rniwase/tsuraraGB/README.md

# tsuraraGB
Nintendo Gameboy cartridge-shaped FPGA (Lattice iCE40UP5K) development board

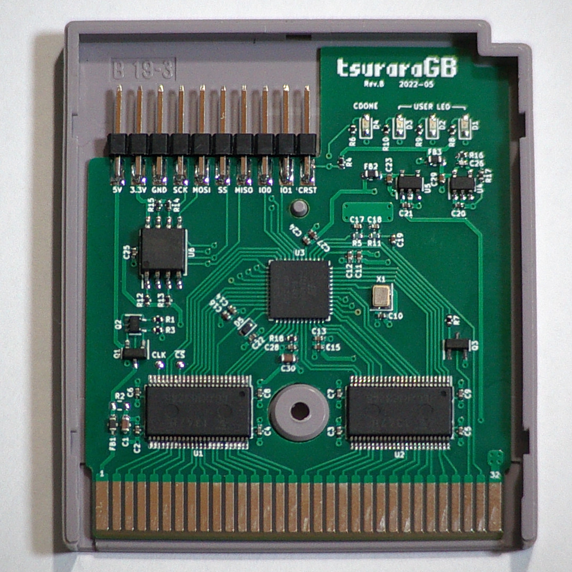
[picture p1: misc/tGB-topview.jpg]

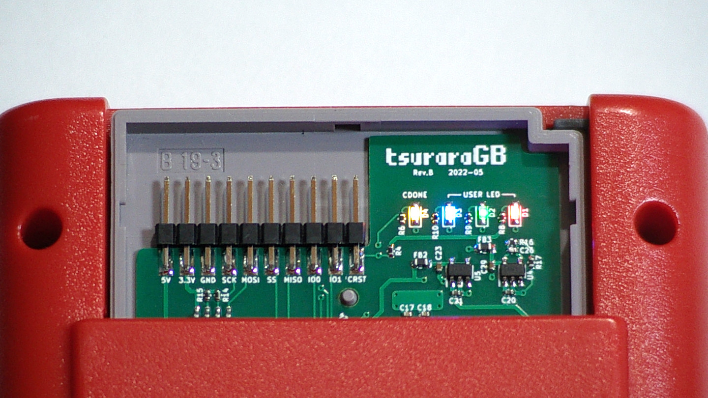
[picture p2: misc/tGB-led.jpg]
