rniwase/tsuraraGB/backpanel/tGB-Assembly.dxf

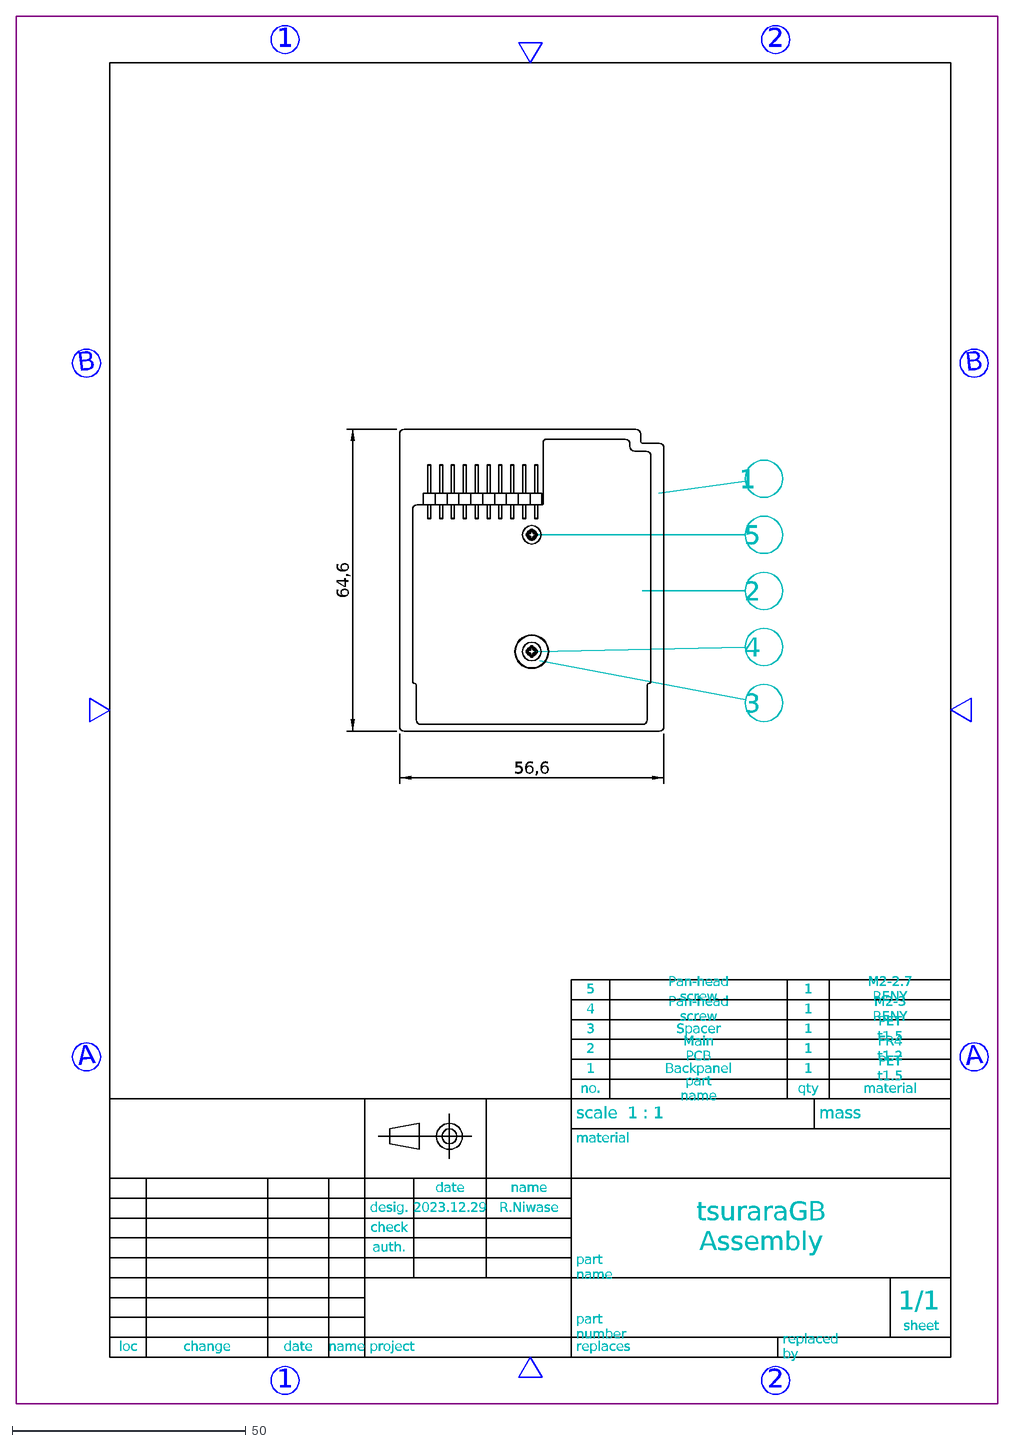
[picture p3: CAD file, 2023-12-29]
backpanel/tGB-Assembly.dxf
sheet
1/1
A
B
1
2
R.Niwase
loc
change
date
name
desig.
check
auth.
project
replaces
replaced by
part number
part name
material
mass
scale 1 : 1
no.
qty
3
4
tsuraraGB Assembly
Backpanel
Main PCB
Spacer
Pan-head screw
M2-3 RENY
5
M2-2.7 RENY
PET t1.5
FR4 t1.2
2023.12.29
56,6
64,6
