rniwase/tsuraraGB/backpanel/tGB-Backpanel.dxf

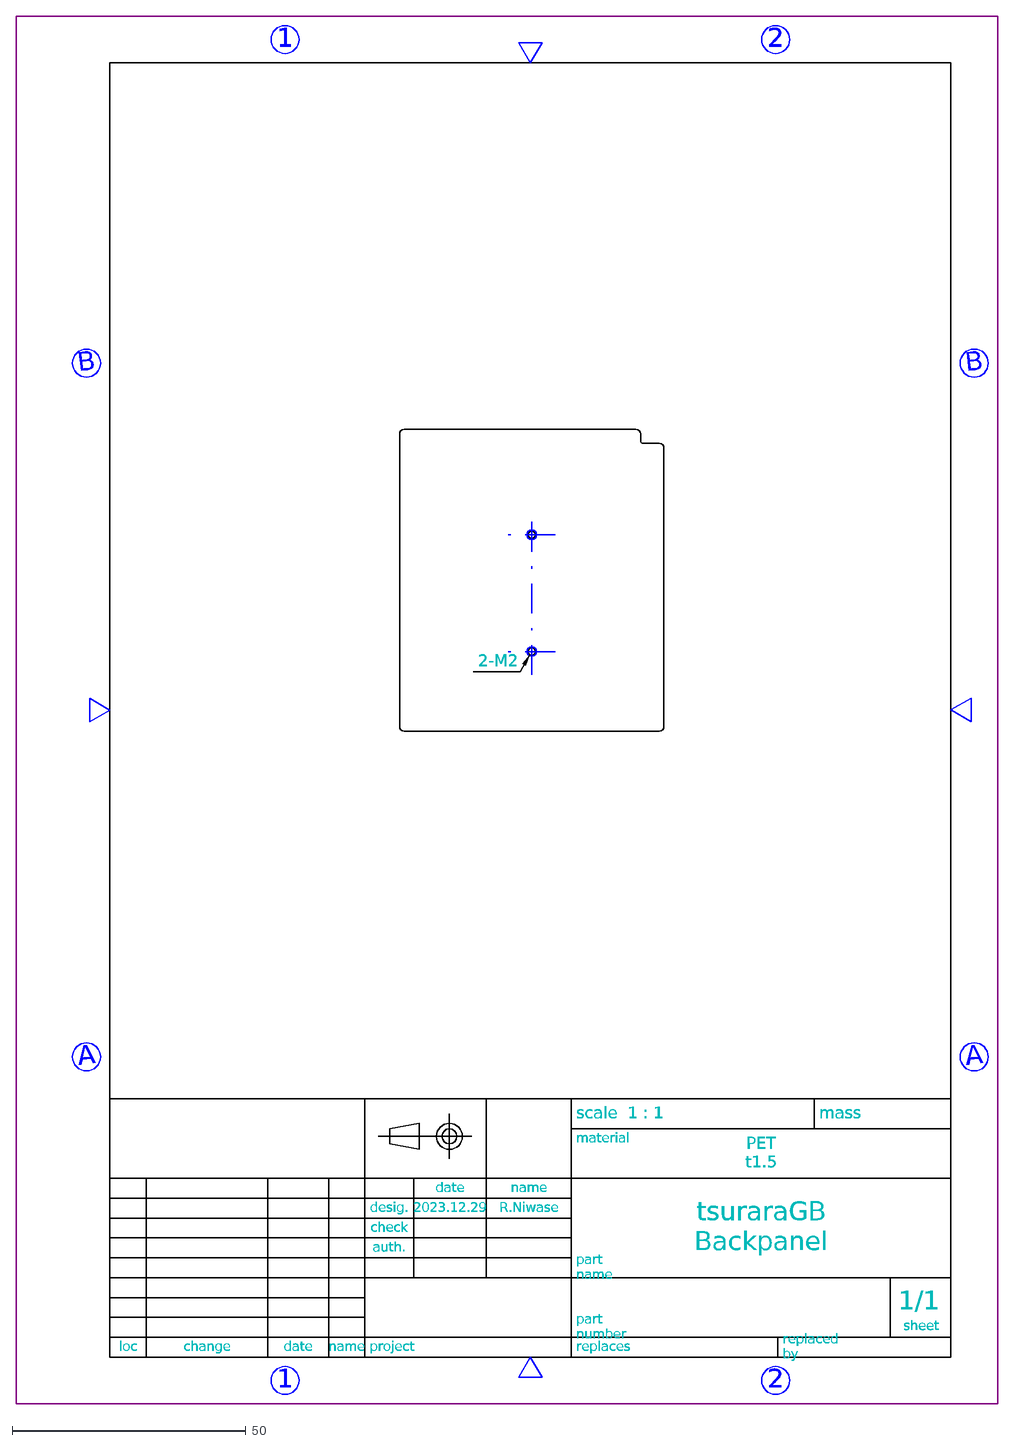
[picture p4: CAD file, 2023-12-29]
backpanel/tGB-Backpanel.dxf
sheet
1/1
A
B
1
2
tsuraraGB Backpanel
R.Niwase
loc
change
date
name
desig.
check
auth.
project
replaces
replaced by
part number
part name
material
mass
PET t1.5
scale 1 : 1
2023.12.29
2-M2
