rniwase/tsuraraGB/backpanel/tGB-Spacer.dxf

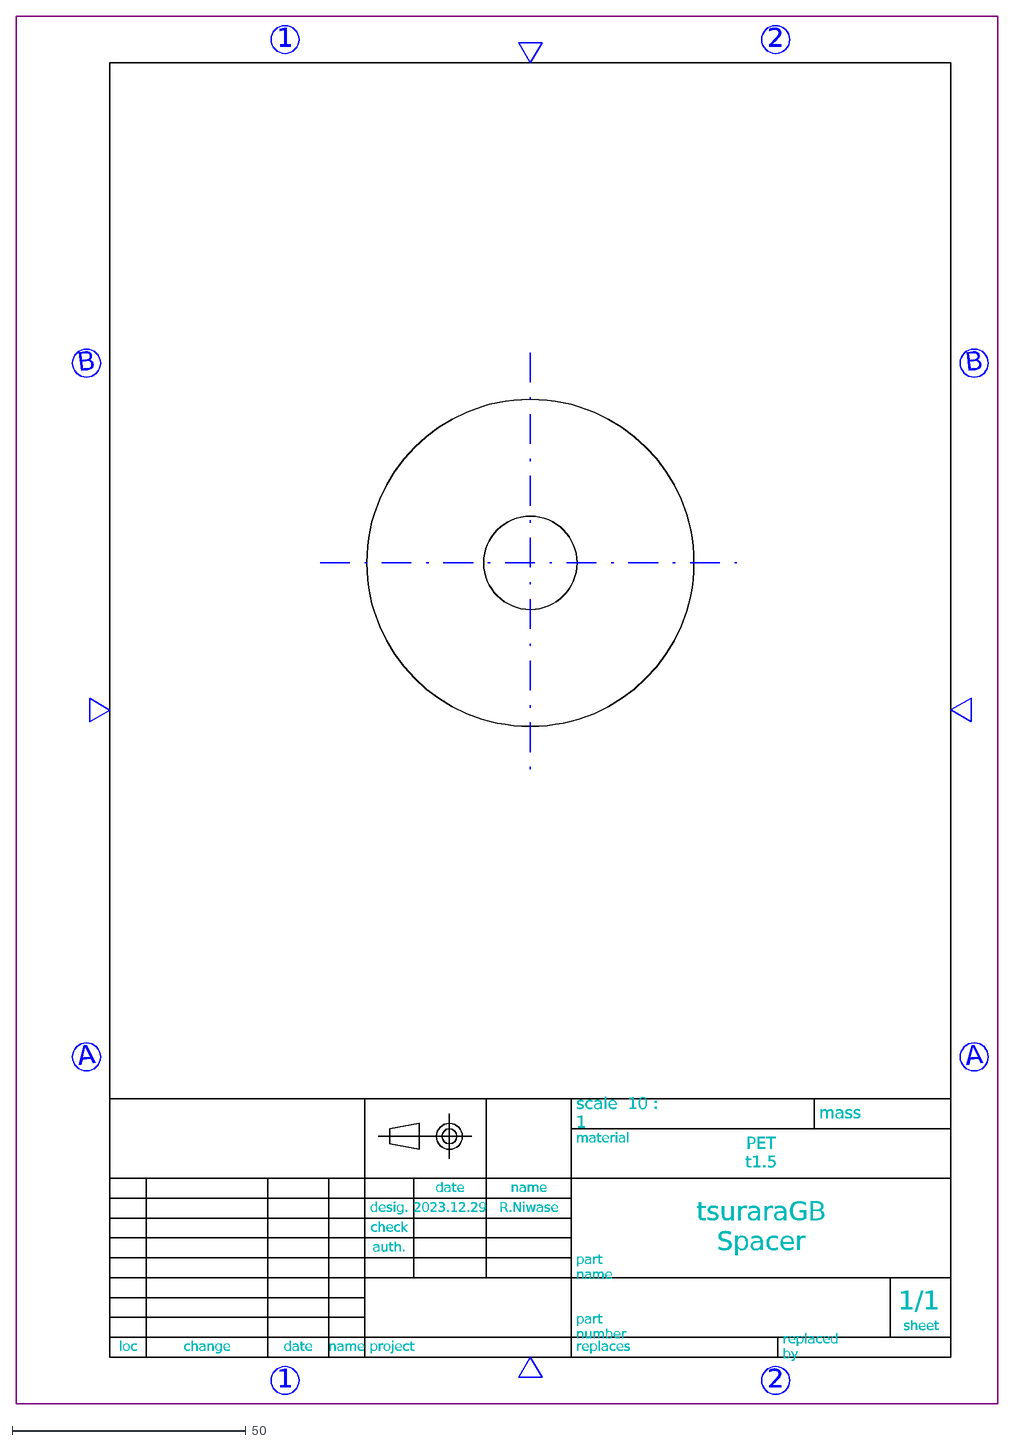
[picture p5: CAD file, 2023-12-29]
backpanel/tGB-Spacer.dxf
sheet
1/1
A
B
1
2
R.Niwase
loc
change
date
name
desig.
check
auth.
project
replaces
replaced by
part number
part name
material
mass
PET t1.5
scale 10 : 1
tsuraraGB Spacer
2023.12.29
