rniwase/tsuraraGB/pcb/programmer/tGB-prog.kicad_pcb

## KiCad design pcb/programmer/tGB-prog.kicad_pcb (2024-01-04)

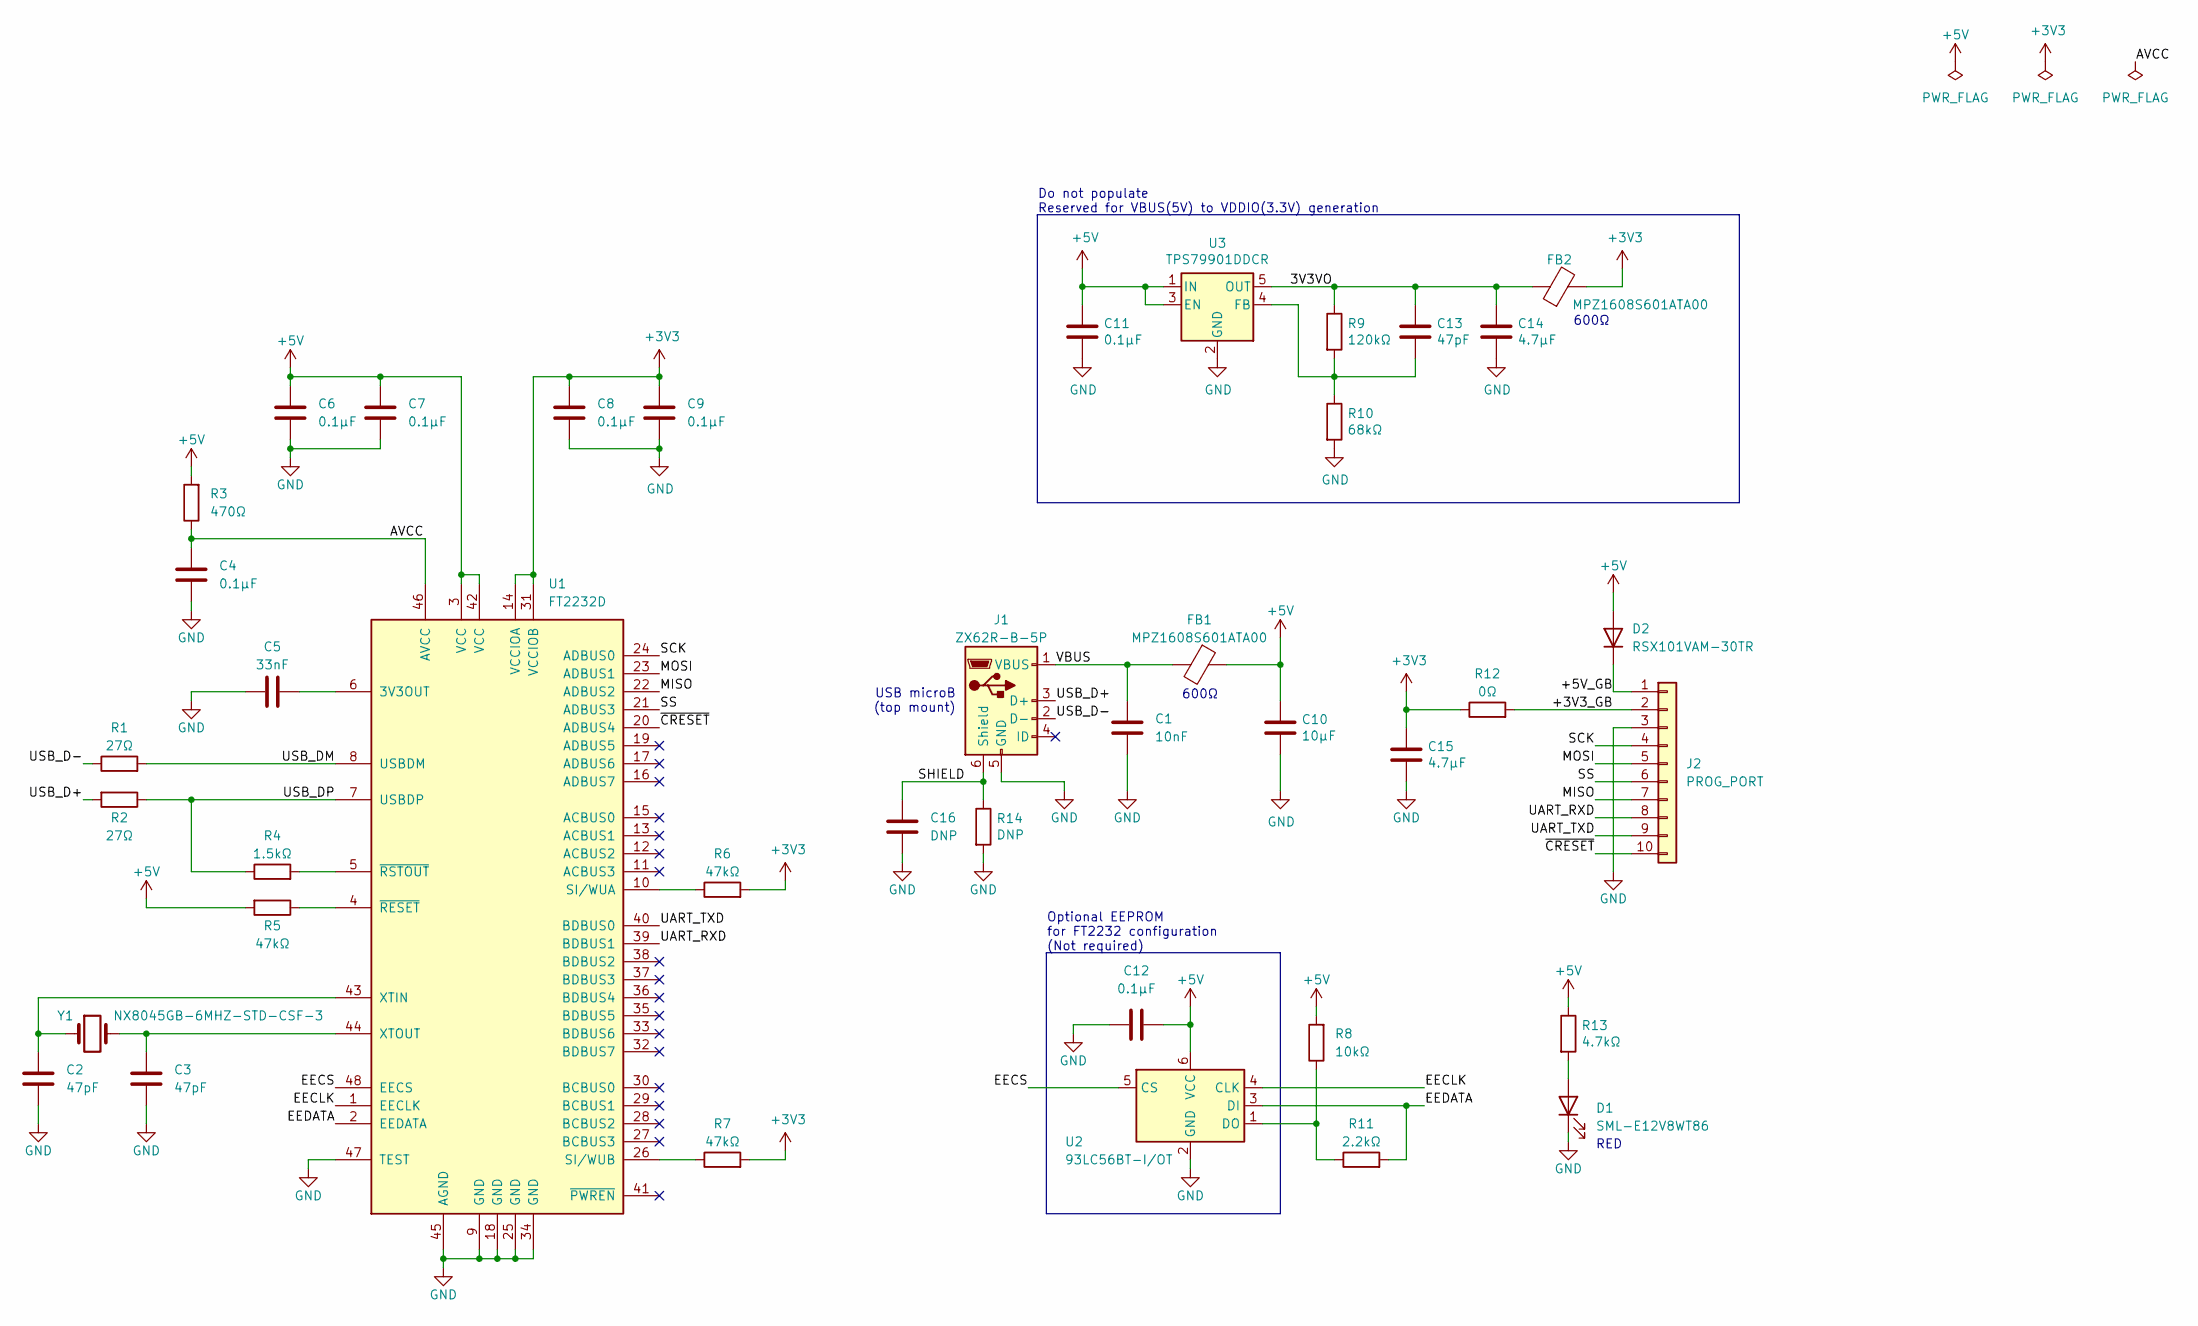
[picture p6: schematic tGB-prog.kicad_sch, tsuraraGB Programmer PCB]

Parts:
C1: 10nF; C_0402_1005Metric
C2, C3, C13: 47pF; C_0402_1005Metric
C4, C6, C7, C8, C9, C11, C12: 0.1μF; C_0402_1005Metric
C5: 33nF; C_0402_1005Metric
C10: 10μF; C_0603_1608Metric
C14: 4.7μF; C_0402_1005Metric
C15: 4.7μF; C_0603_1608Metric
C16: DNP; C_0402_1005Metric
D1: SML-E12V8WT86; LED_0603_1608Metric_Castellated
D2: RSX101VAM-30TR; D_TUMD2
FB1, FB2: MPZ1608S601ATA00; L_0603_1608Metric
J1: ZX62R-B-5P
J2: PROG_PORT; PinSocket_1x10_P2.54_Sidemount
R1, R2: 27Ω; R_0402_1005Metric
R3: 470Ω; R_0402_1005Metric
R4: 1.5kΩ; R_0402_1005Metric
R5, R6, R7: 47kΩ; R_0402_1005Metric
R8: 10kΩ; R_0402_1005Metric
R9: 120kΩ; R_0402_1005Metric
R10: 68kΩ; R_0402_1005Metric
R11: 2.2kΩ; R_0402_1005Metric
R12: 0Ω; R_0603_1608Metric
R13: 4.7kΩ; R_0402_1005Metric
R14: DNP; R_0402_1005Metric
U1: FT2232D; LQFP-48_7x7mm_P0.5mm
U2: 93LC56BT-I/OT; SOT-23-6
U3: TPS79901DDCR; SOT-23-5
Y1: NX8045GB-6MHZ-STD-CSF-3; Crystal_SMD_TXC_AX_8045-2Pin_8.0x4.5mm

Connections:
+3V3: C8.1, C9.1, C15.1, FB2.2, R6.2, R7.2, R12.1, U1.14 (VCCIOA), U1.31 (VCCIOB)
+5V: C6.1, C7.1, C10.1, C11.1, C12.2, D2.2 (A), FB1.1, R3.2, R5.2, R8.2, R13.1, U1.3 (VCC), U1.42 (VCC), U2.6 (VCC), U3.1 (IN), U3.3 (EN)
/3V3VO: C13.1, C14.1, FB2.1, R9.1, U3.5 (OUT)
/+3V3_GB: J2.2, R12.2
/+5V_GB: D2.1 (K), J2.1
/AVCC: C4.1, R3.1, U1.46 (AVCC)
/EECLK: U1.1 (EECLK), U2.4 (CLK)
/EECS: U1.48 (EECS), U2.5 (CS)
/EEDATA: R11.2, U1.2 (EEDATA), U2.3 (DI)
/MISO: J2.7, U1.22 (ADBUS2)
/MOSI: J2.5, U1.23 (ADBUS1)
/SCK: J2.4, U1.24 (ADBUS0)
/SHIELD: C16.1, J1.6 (Shield), R14.1
/SS: J2.6, U1.21 (ADBUS3)
/UART_RXD: J2.8, U1.39 (BDBUS1)
/UART_TXD: J2.9, U1.40 (BDBUS0)
/USB_D+: J1.3 (D+), R2.2
/USB_D-: J1.2 (D-), R1.1
/USB_DM: R1.2, U1.8 (USBDM)
/USB_DP: R2.1, R4.1, U1.7 (USBDP)
/VBUS: C1.1, FB1.2, J1.1 (VBUS)
/~CRESET: J2.10, U1.20 (ADBUS4)
GND: C1.2, C2.2, C3.2, C4.2, C5.1, C6.2, C7.2, C8.2, C9.2, C10.2, C11.2, C12.1, C14.2, C15.2, C16.2, D1.1 (K), J1.5 (GND), J2.3, R10.2, R14.2, U1.9 (GND), U1.18 (GND), U1.25 (GND), U1.34 (GND), U1.45 (AGND), U1.47 (TEST), U2.2 (GND), U3.2 (GND)
unnamed: D1.2 (A), R13.2
unnamed: C5.2, U1.6 (3V3OUT)
unnamed: R6.1, U1.10 (SI/WUA)
unnamed: R7.1, U1.26 (SI/WUB)
unnamed: C2.1, U1.43 (XTIN), Y1.1
unnamed: C3.1, U1.44 (XTOUT), Y1.2
unnamed: R5.1, U1.4 (~RESET)
unnamed: R4.2, U1.5 (~RSTOUT)
unnamed: R8.1, R11.1, U2.1 (DO)
unnamed: C13.2, R9.2, R10.1, U3.4 (FB)

Notes on the sheet:
600Ω
USB microB (top mount)
RED
Do not populate Reserved for VBUS(5V) to VDDIO(3.3V) generation
Optional EEPROM for FT2232 configuration (Not required)

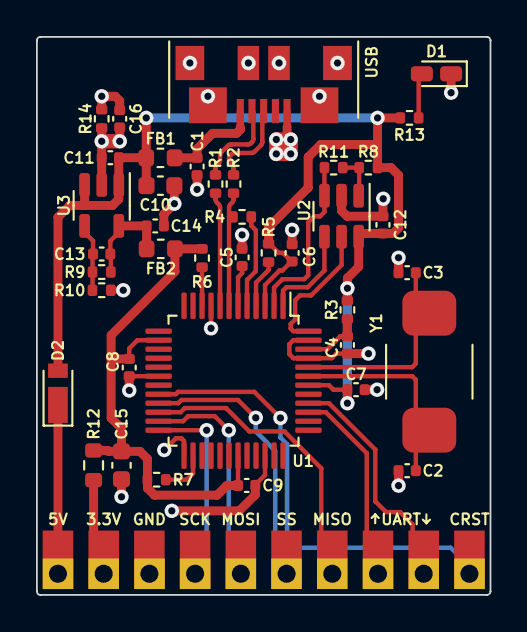
[picture p7: board tGB-prog.kicad_pcb from above]

Board: 2 copper layers, 25.2 x 31.0 mm, 40 parts (0 on the bottom side), 33 nets.
