rniwase/tsuraraGB/pcb/midi/tGB-midi.kicad_pcb

## KiCad design pcb/midi/tGB-midi.kicad_pcb (2024-01-04)

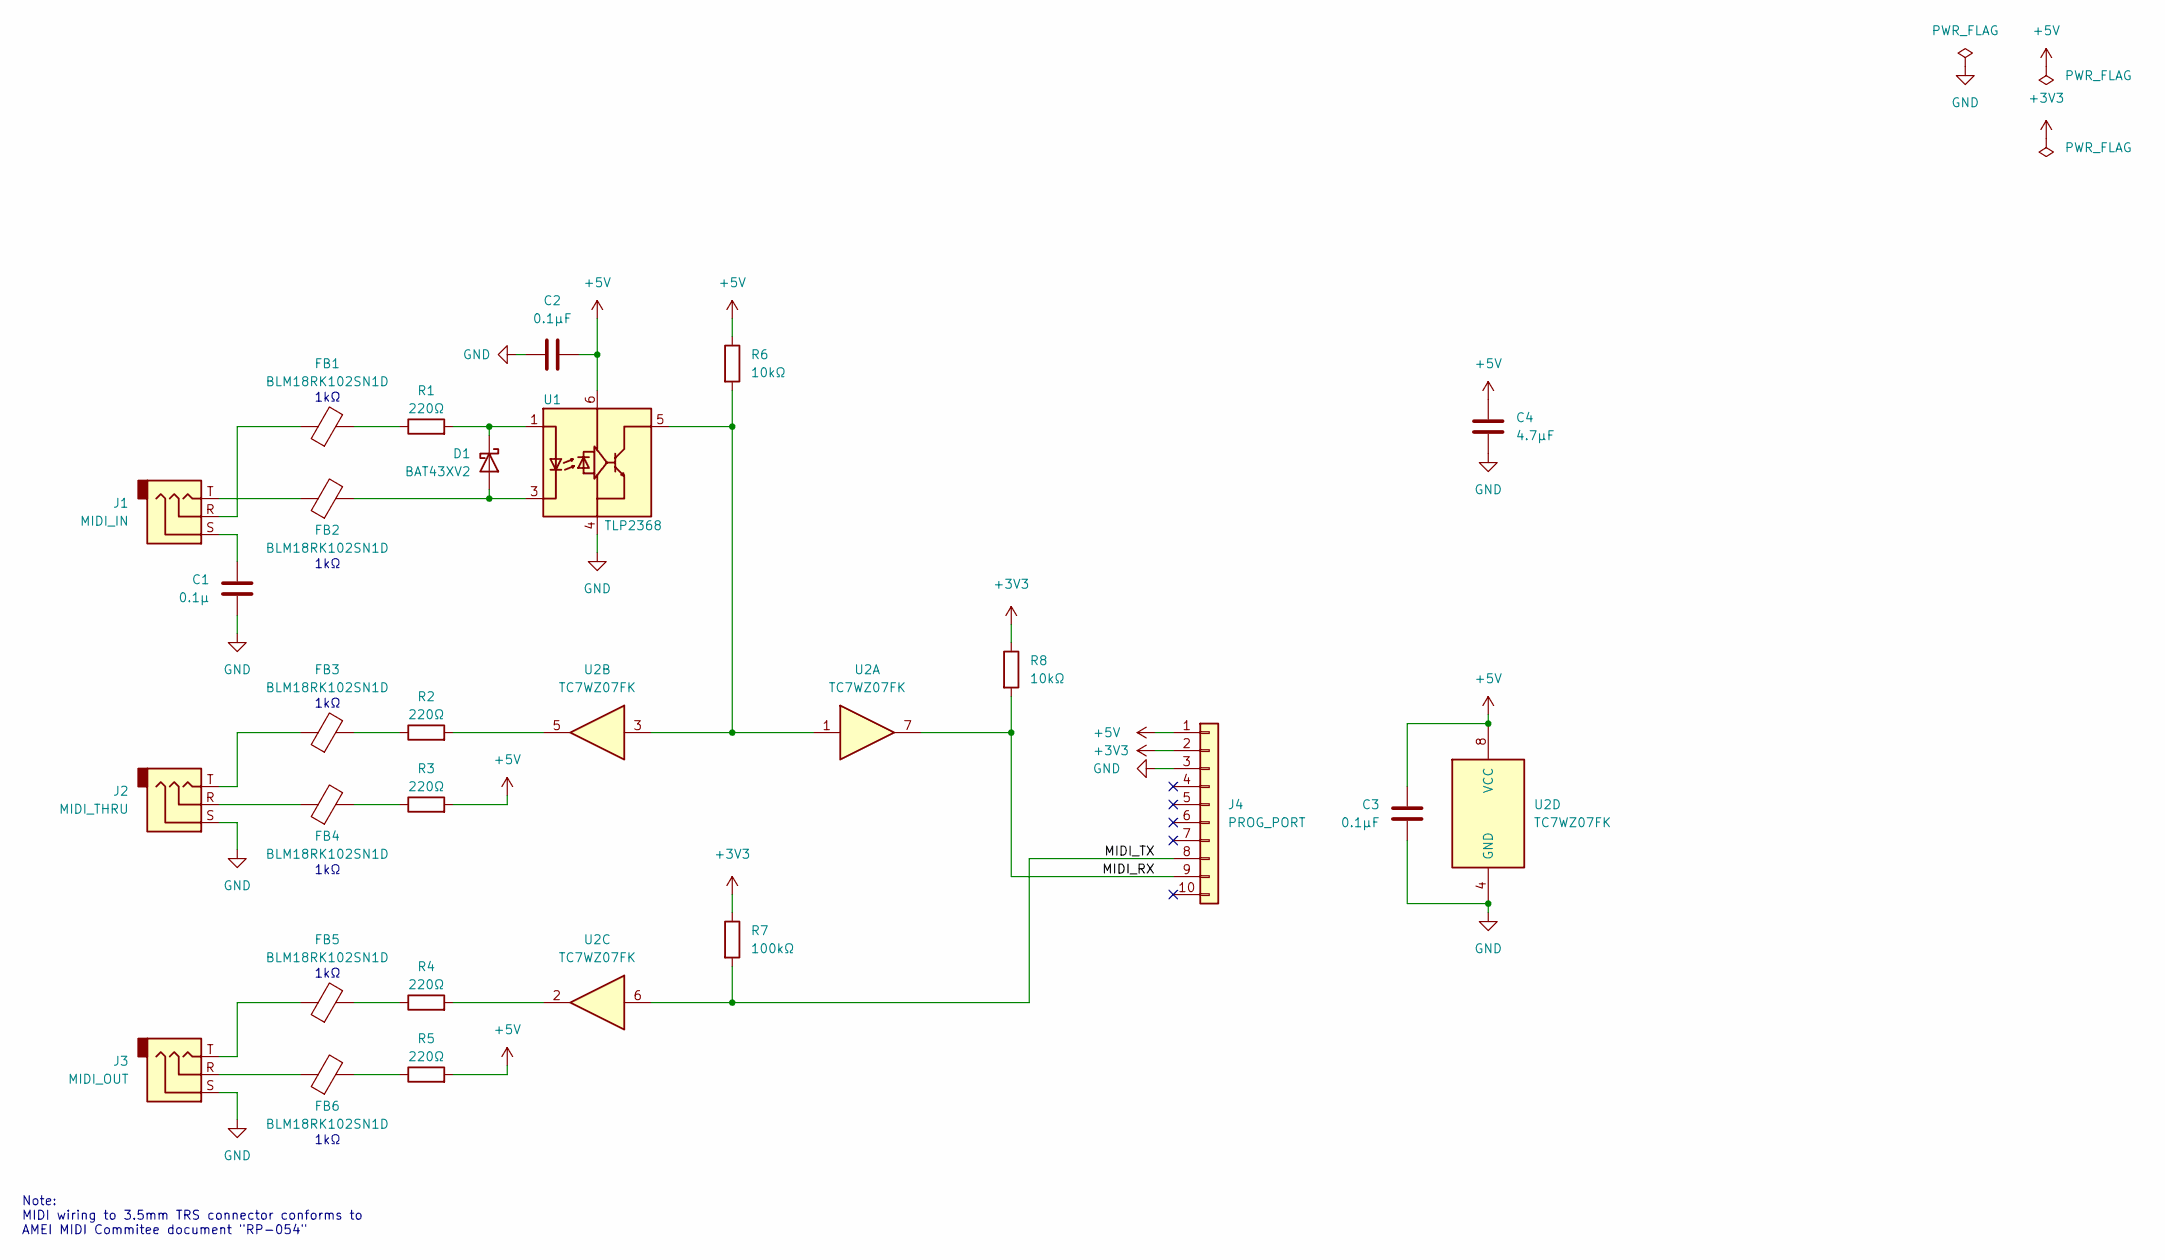
[picture p8: schematic tGB-midi.kicad_sch, tsuraraGB MIDI Adapter PCB]

Parts:
C1: 0.1μ; C_0402_1005Metric
C2, C3: 0.1μF; C_0402_1005Metric
C4: 4.7μF; C_0402_1005Metric
D1: BAT43XV2; D_SOD-523
FB1, FB2, FB3, FB4, FB5, FB6: BLM18RK102SN1D; L_0603_1608Metric
J1: MIDI_IN; MJ-8435
J2: MIDI_THRU; MJ-8435
J3: MIDI_OUT; MJ-8435
J4: PROG_PORT; PinSocket_1x10_P2.54_Sidemount
R1, R2, R3, R4, R5: 220Ω; R_0402_1005Metric
R6, R8: 10kΩ; R_0402_1005Metric
R7: 100kΩ; R_0402_1005Metric
U1: TLP2368; SO-5_4.4x3.6mm_P1.27mm
U2: TC7WZ07FK; VSSOP-8_2.3x2mm_P0.5mm

Connections:
+3V3: J4.2, R7.1, R8.1
+5V: C2.2, C3.2, C4.1, J4.1, R3.2, R5.2, R6.1, U1.6 (VDD), U2.8 (VCC)
/MIDI_RX: J4.9, R8.2, U2.7
/MIDI_TX: J4.8, R7.2, U2.6
GND: C1.1, C2.1, C3.1, C4.2, J2.S, J3.S, J4.3, U1.4 (GND), U2.4 (GND)
unnamed: C1.2, J1.S
unnamed: D1.2 (A), FB2.2, U1.3 (K)
unnamed: D1.1 (K), R1.2, U1.1 (A)
unnamed: FB1.1, J1.R
unnamed: FB1.2, R1.1
unnamed: FB2.1, J1.T
unnamed: FB3.1, J2.T
unnamed: FB3.2, R2.1
unnamed: FB4.1, J2.R
unnamed: FB4.2, R3.1
unnamed: FB5.1, J3.T
unnamed: FB5.2, R4.1
unnamed: FB6.1, J3.R
unnamed: FB6.2, R5.1
unnamed: R2.2, U2.5
unnamed: R4.2, U2.2
unnamed: R6.2, U1.5 (VO), U2.1, U2.3

Notes on the sheet:
1kΩ
Note: MIDI wiring to 3.5mm TRS connector conforms to AMEI MIDI Commitee document "RP-054"

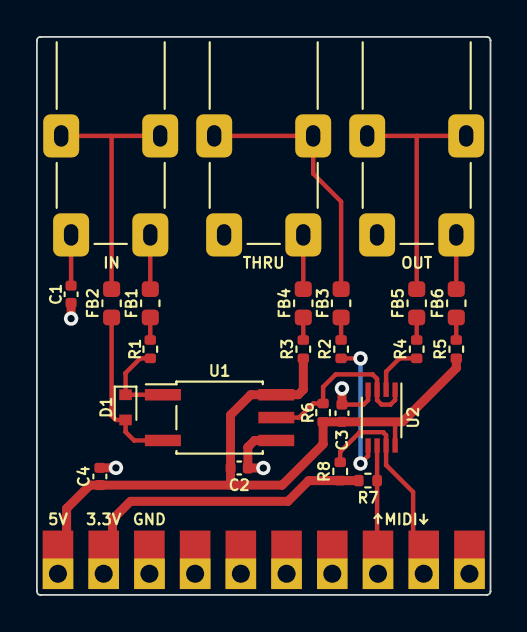
[picture p9: board tGB-midi.kicad_pcb from above]

Board: 2 copper layers, 25.2 x 31.0 mm, 25 parts (0 on the bottom side), 22 nets.
