rniwase/tsuraraGB/pcb/main/tGB-main.kicad_pcb

## KiCad design pcb/main/tGB-main.kicad_pcb (2024-01-04)

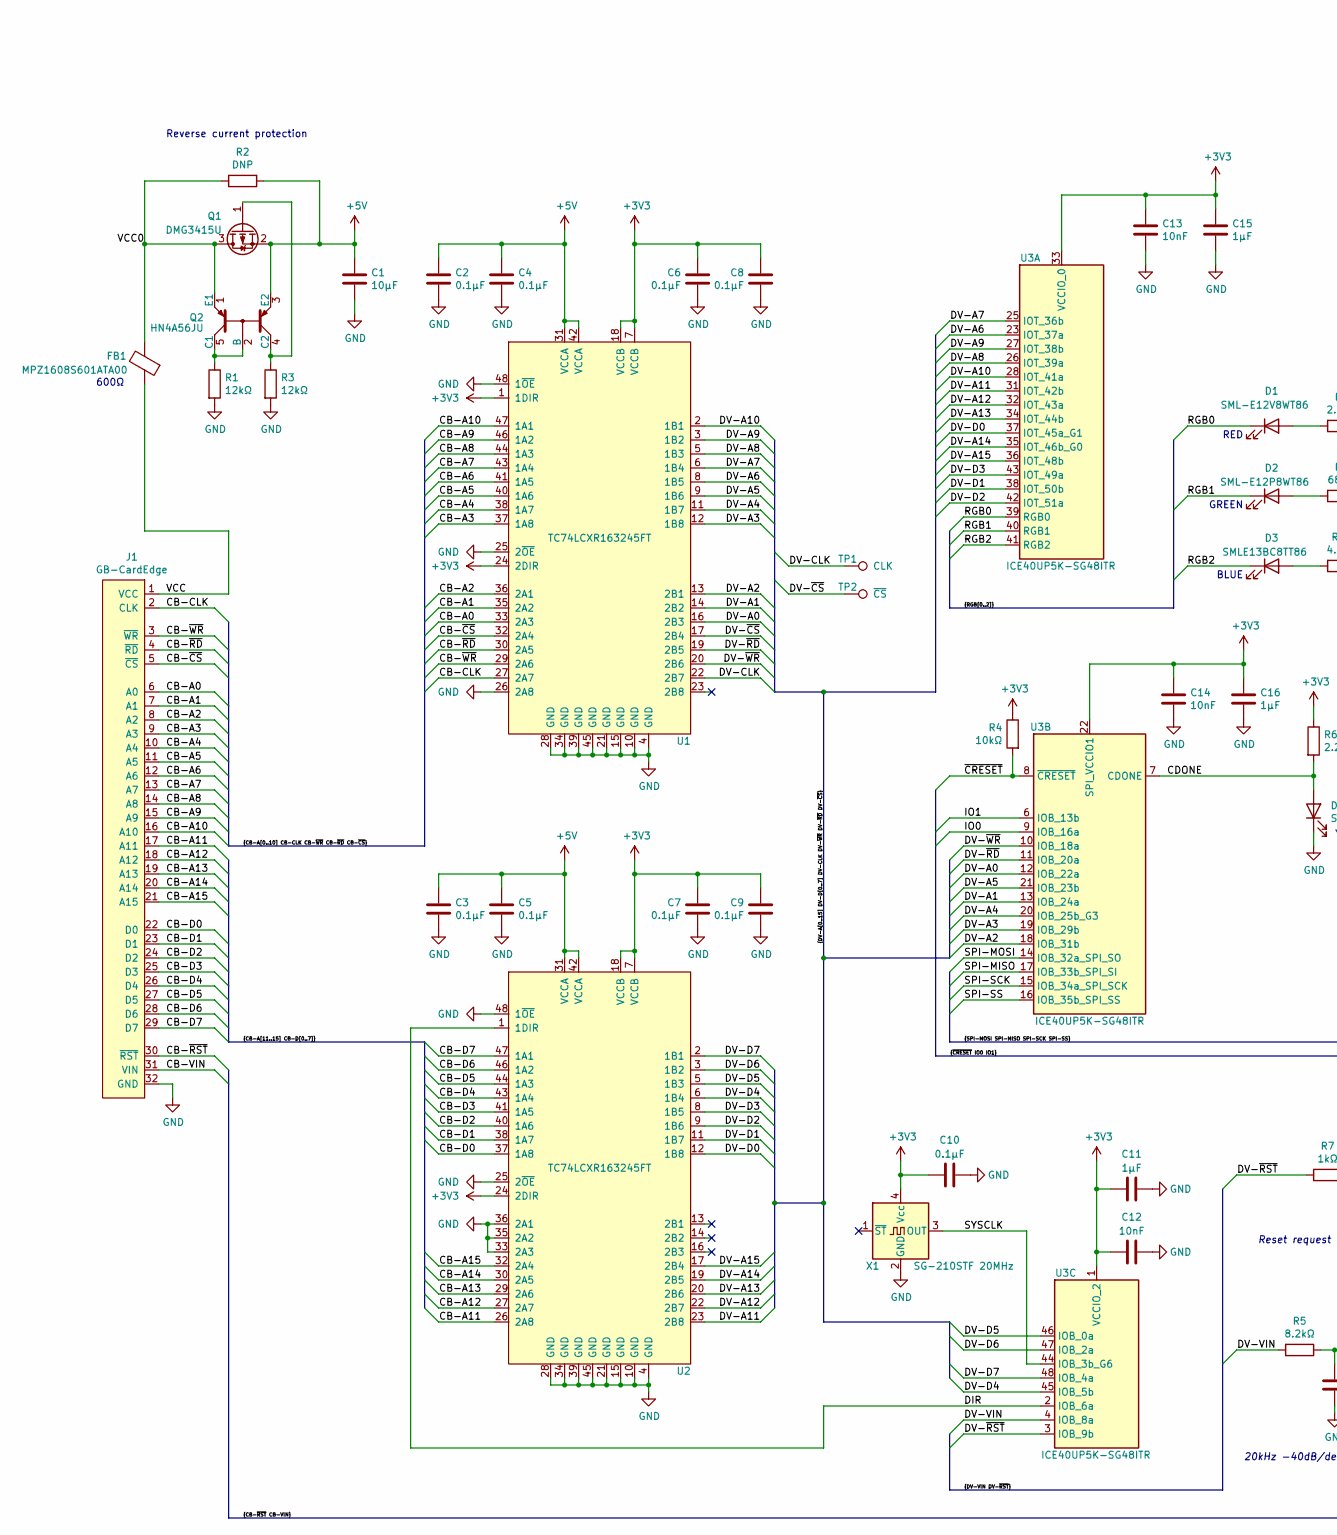
[picture p10: schematic tGB-main.kicad_sch, tsuraraGB Main PCB, part in row 1, column 1]

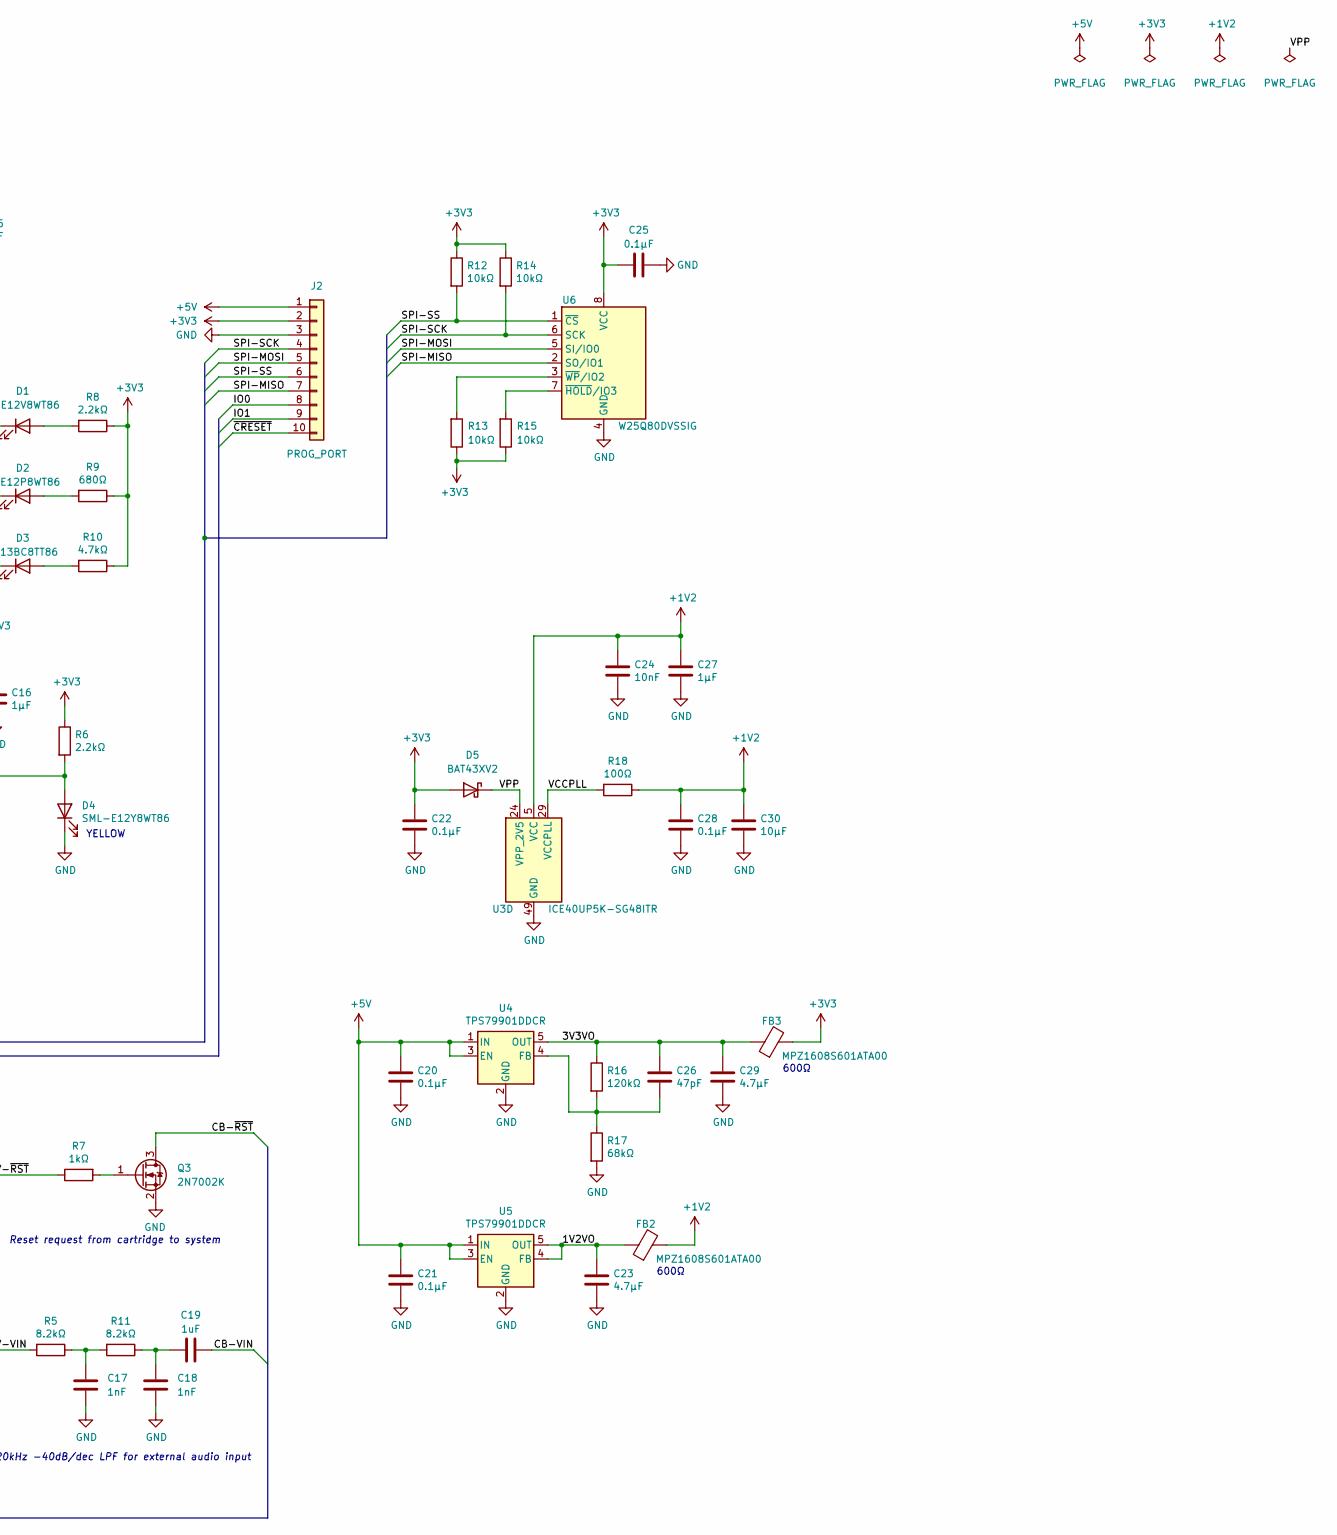
[picture p11: schematic tGB-main.kicad_sch, tsuraraGB Main PCB, part in row 1, column 2]

Parts:
C1, C30: 10μF; C_0603_1608Metric
C2, C3, C4, C5, C6, C7, C8, C9, C10, C20, C21, C22, C25, C28: 0.1μF; C_0402_1005Metric
C11, C15, C16, C27: 1μF; C_0402_1005Metric
C12, C13, C14, C24: 10nF; C_0402_1005Metric
C17, C18: 1nF; C_0402_1005Metric
C19: 1uF; C_0402_1005Metric
C23, C29: 4.7μF; C_0402_1005Metric
C26: 47pF; C_0402_1005Metric
D1: SML-E12V8WT86; LED_0603_1608Metric_Castellated
D2: SML-E12P8WT86; LED_0603_1608Metric_Castellated
D3: SMLE13BC8TT86; LED_0603_1608Metric_Castellated
D4: SML-E12Y8WT86; LED_0603_1608Metric_Castellated
D5: BAT43XV2; D_SOD-523
FB1, FB2, FB3: MPZ1608S601ATA00; L_0603_1608Metric
J1: GB-CardEdge
J2: PROG_PORT; PinHeader_1x10_P2.54_Sidemount
Q1: DMG3415U; SOT-23
Q2: HN4A56JU; SOT-353_SC-70-5
Q3: 2N7002K; SOT-23
R1, R3: 12kΩ; R_0402_1005Metric
R2: DNP; R_0603_1608Metric
R4, R12, R13, R14, R15: 10kΩ; R_0402_1005Metric
R5, R11: 8.2kΩ; R_0402_1005Metric
R6, R8: 2.2kΩ; R_0402_1005Metric
R7: 1kΩ; R_0402_1005Metric
R9: 680Ω; R_0402_1005Metric
R10: 4.7kΩ; R_0402_1005Metric
R16: 120kΩ; R_0402_1005Metric
R17: 68kΩ; R_0402_1005Metric
R18: 100Ω; R_0402_1005Metric
TP1: CLK; TestPoint_Pad_D1.0mm
TP2: ~{CS}; TestPoint_Pad_D1.0mm
U1, U2: TC74LCXR163245FT; TSSOP-48_6.1x12.5mm_P0.5mm
U3: ICE40UP5K-SG48ITR; QFN-48-1EP_7x7mm_P0.5mm_EP5.6x5.6mm
U4, U5: TPS79901DDCR; SOT-23-5
U6: W25Q80DVSSIG; SOIC-8_5.275x5.275mm_P1.27mm
X1: SG-210STF 20MHz; Oscillator_SMD_SeikoEpson_SG210-4Pin_2.5x2.0mm

Connections:
+1V2: C24.1, C27.1, C28.1, C30.1, FB2.2, R18.1, U3.5 (VCC), U3.30 (VCC)
+3V3: C6.1, C7.1, C8.1, C9.1, C10.1, C11.1, C12.1, C13.1, C14.1, C15.1, C16.1, C22.1, C25.1, D5.2 (A), FB3.2, J2.2, R4.1, R6.1, R8.1, R9.1, R10.1, R12.1, R13.1, R14.1, R15.1, U1.1 (1DIR), U1.7 (VCCB), U1.18 (VCCB), U1.24 (2DIR), U2.7 (VCCB), U2.18 (VCCB), U2.24 (2DIR), U3.1 (VCCIO_2), U3.22 (SPI_VCCIO1), U3.33 (VCCIO_0), U6.8 (VCC), X1.4 (Vcc); also elsewhere on the board
+5V: C1.1, C2.1, C3.1, C4.1, C5.1, C20.1, C21.1, J2.1, Q1.2 (S), Q2.3 (E2), R2.2, U1.31 (VCCA), U1.42 (VCCA), U2.31 (VCCA), U2.42 (VCCA), U4.1 (IN), U4.3 (EN), U5.1 (IN), U5.3 (EN); also elsewhere on the board
/1V2VO: C23.1, FB2.1, U5.4 (FB), U5.5 (OUT)
/3V3VO: C26.1, C29.1, FB3.1, R16.1, U4.5 (OUT)
/CB-A0: J1.6 (A0), U1.33 (2A3)
/CB-A1: J1.7 (A1), U1.35 (2A2)
/CB-A2: J1.8 (A2), U1.36 (2A1)
/CB-A3: J1.9 (A3), U1.37 (1A8)
/CB-A4: J1.10 (A4), U1.38 (1A7)
/CB-A5: J1.11 (A5), U1.40 (1A6)
/CB-A6: J1.12 (A6), U1.41 (1A5)
/CB-A7: J1.13 (A7), U1.43 (1A4)
/CB-A8: J1.14 (A8), U1.44 (1A3)
/CB-A9: J1.15 (A9), U1.46 (1A2)
/CB-A10: J1.16 (A10), U1.47 (1A1)
/CB-A11: J1.17 (A11), U2.26 (2A8); also elsewhere on the board
/CB-A12: J1.18 (A12), U2.27 (2A7); also elsewhere on the board
/CB-A13: J1.19 (A13), U2.29 (2A6); also elsewhere on the board
/CB-A14: J1.20 (A14), U2.30 (2A5); also elsewhere on the board
/CB-A15: J1.21 (A15), U2.32 (2A4); also elsewhere on the board
/CB-CLK: J1.2 (CLK), U1.27 (2A7)
/CB-D0: J1.22 (D0), U2.37 (1A8); also elsewhere on the board
/CB-D1: J1.23 (D1), U2.38 (1A7); also elsewhere on the board
/CB-D2: J1.24 (D2), U2.40 (1A6); also elsewhere on the board
/CB-D3: J1.25 (D3), U2.41 (1A5); also elsewhere on the board
/CB-D4: J1.26 (D4), U2.43 (1A4); also elsewhere on the board
/CB-D5: J1.27 (D5), U2.44 (1A3); also elsewhere on the board
/CB-D6: J1.28 (D6), U2.46 (1A2); also elsewhere on the board
/CB-D7: J1.29 (D7), U2.47 (1A1); also elsewhere on the board
/CB-VIN: C19.1, J1.31 (VIN)
/CB-~CS: J1.5 (~CS), U1.32 (2A4)
/CB-~RD: J1.4 (~RD), U1.30 (2A5)
/CB-~RST: J1.30 (~RST), Q3.3 (D)
/CB-~WR: J1.3 (~WR), U1.29 (2A6)
/CDONE: D4.2 (A), R6.2, U3.7 (CDONE)
/DIR: U2.1 (1DIR), U3.2 (IOB_6a); also elsewhere on the board
/DV-A0: U1.16 (2B3), U3.12 (IOB_22a)
/DV-A1: U1.14 (2B2), U3.13 (IOB_24a)
/DV-A2: U1.13 (2B1), U3.18 (IOB_31b)
/DV-A3: U1.12 (1B8), U3.19 (IOB_29b)
/DV-A4: U1.11 (1B7), U3.20 (IOB_25b_G3)
/DV-A5: U1.9 (1B6), U3.21 (IOB_23b)
/DV-A6: U1.8 (1B5), U3.23 (IOT_37a)
/DV-A7: U1.6 (1B4), U3.25 (IOT_36b)
/DV-A8: U1.5 (1B3), U3.26 (IOT_39a)
/DV-A9: U1.3 (1B2), U3.27 (IOT_38b)
/DV-A10: U1.2 (1B1), U3.28 (IOT_41a)
/DV-A11: U2.23 (2B8), U3.31 (IOT_42b); also elsewhere on the board
/DV-A12: U2.22 (2B7), U3.32 (IOT_43a); also elsewhere on the board
/DV-A13: U2.20 (2B6), U3.34 (IOT_44b); also elsewhere on the board
/DV-A14: U2.19 (2B5), U3.35 (IOT_46b_G0); also elsewhere on the board
/DV-A15: U2.17 (2B4), U3.36 (IOT_48b); also elsewhere on the board
/DV-CLK: TP1.1, U1.22 (2B7)
/DV-D0: U2.12 (1B8), U3.37 (IOT_45a_G1); also elsewhere on the board
/DV-D1: U2.11 (1B7), U3.38 (IOT_50b); also elsewhere on the board
/DV-D2: U2.9 (1B6), U3.42 (IOT_51a); also elsewhere on the board
/DV-D3: U2.8 (1B5), U3.43 (IOT_49a); also elsewhere on the board
/DV-D4: U2.6 (1B4), U3.45 (IOB_5b); also elsewhere on the board
/DV-D5: U2.5 (1B3), U3.46 (IOB_0a); also elsewhere on the board
/DV-D6: U2.3 (1B2), U3.47 (IOB_2a); also elsewhere on the board
/DV-D7: U2.2 (1B1), U3.48 (IOB_4a); also elsewhere on the board
/DV-VIN: R5.2, U3.4 (IOB_8a)
/DV-~CS: TP2.1, U1.17 (2B4)
/DV-~RD: U1.19 (2B5), U3.11 (IOB_20a)
/DV-~RST: R7.1, U3.3 (IOB_9b)
/DV-~WR: U1.20 (2B6), U3.10 (IOB_18a)
/IO0: J2.8, U3.9 (IOB_16a)
/IO1: J2.9, U3.6 (IOB_13b)
/RGB0: D1.1 (K), U3.39 (RGB0)
/RGB1: D2.1 (K), U3.40 (RGB1)
/RGB2: D3.1 (K), U3.41 (RGB2)
/SPI-MISO: J2.7, U3.17 (IOB_33b_SPI_SI), U6.2 (SO/IO1)
/SPI-MOSI: J2.5, U3.14 (IOB_32a_SPI_SO), U6.5 (SI/IO0)
/SPI-SCK: J2.4, R14.2, U3.15 (IOB_34a_SPI_SCK), U6.6 (SCK)
/SPI-SS: J2.6, R12.2, U3.16 (IOB_35b_SPI_SS), U6.1 (~CS)
/SYSCLK: U3.44 (IOB_3b_G6), X1.3 (OUT)
/VCC: FB1.1, J1.1 (VCC)
/VCC0: FB1.2, Q1.3 (D), Q2.1 (E1), R2.1
/VCCPLL: R18.2, U3.29 (VCCPLL)
/VPP: D5.1 (K), U3.24 (VPP_2V5)
/~CRESET: J2.10, R4.2, U3.8 (~CRESET)
GND: C1.2, C2.2, C3.2, C4.2, C5.2, C6.2, C7.2, C8.2, C9.2, C10.2, C11.2, C12.2, C13.2, C14.2, C15.2, C16.2, C17.2, C18.2, C20.2, C21.2, C22.2, C23.2, C24.2, C25.2, C27.2, C28.2, C29.2, C30.2, D4.1 (K), J1.32 (GND), J2.3, Q3.2 (S), R1.2, R3.2, R17.2, U1.4 (GND), U1.10 (GND), U1.15 (GND), U1.21 (GND), U1.25 (2~OE), U1.26 (2A8), U1.28 (GND), U1.34 (GND), U1.39 (GND), U1.45 (GND), U1.48 (1~OE), U2.4 (GND), U2.10 (GND), U2.15 (GND), U2.21 (GND), U2.25 (2~OE), U2.28 (GND), U2.33 (2A3), U2.34 (GND), U2.35 (2A2), U2.36 (2A1), U2.39 (GND), U2.45 (GND), U2.48 (1~OE), U3.49 (GND), U4.2 (GND), U5.2 (GND), U6.4 (GND), X1.2 (GND); also elsewhere on the board
unnamed: C17.1, R5.1, R11.2
unnamed: C18.1, C19.2, R11.1
unnamed: D1.2 (A), R8.2
unnamed: D2.2 (A), R9.2
unnamed: D3.2 (A), R10.2
unnamed: Q1.1 (G), Q2.4 (C2), R3.1
unnamed: Q2.2 (B), Q2.5 (C1), R1.1
unnamed: Q3.1 (G), R7.2
unnamed: C26.2, R16.2, R17.1, U4.4 (FB)
unnamed: R15.2, U6.7 (~HOLD/IO3)
unnamed: R13.2, U6.3 (~WP/IO2)

Notes on the sheet:
GREEN
600Ω
YELLOW
RED
Reverse current protection
Reset request from cartridge to system
BLUE
20kHz -40dB/dec LPF for external audio input

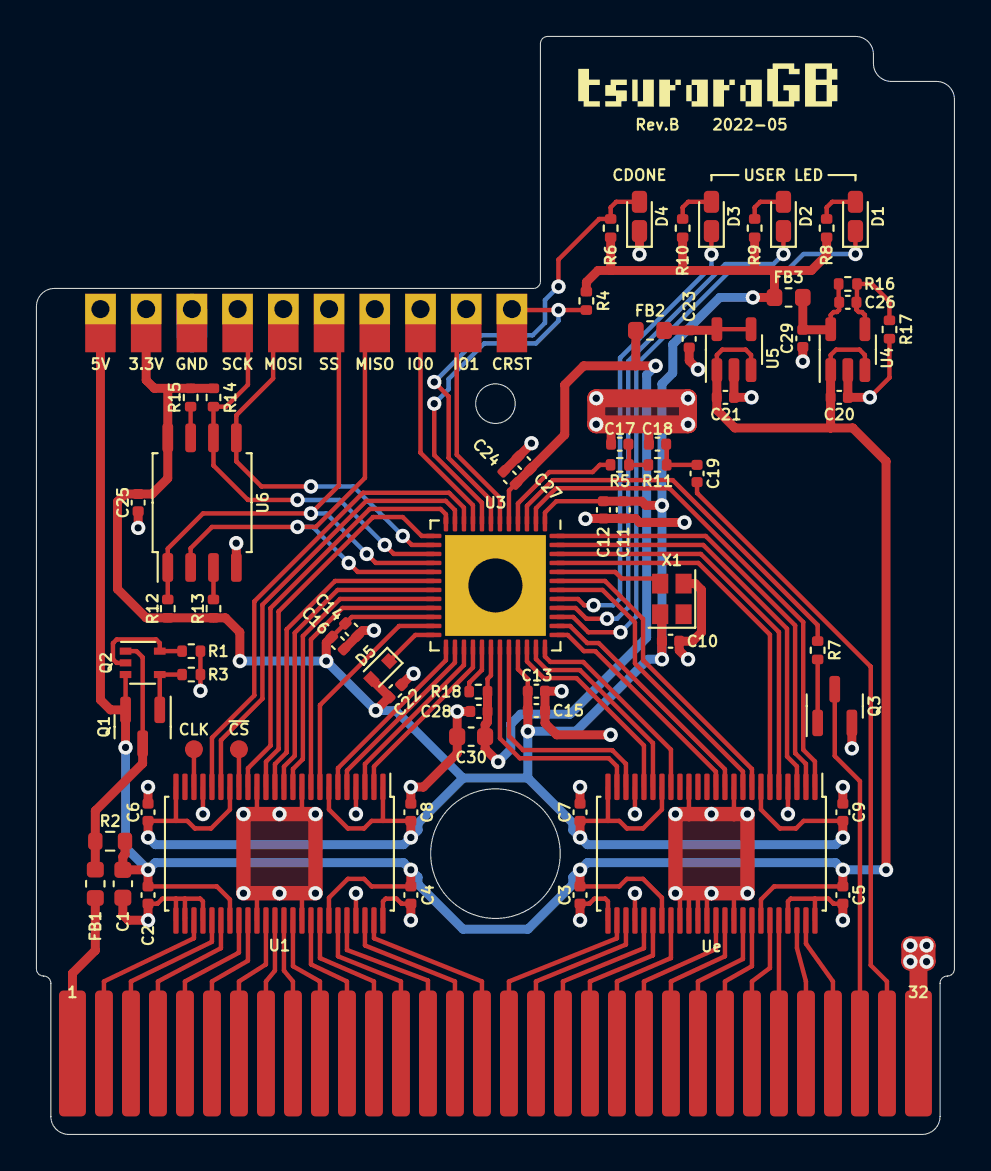
[picture p12: board tGB-main.kicad_pcb from above]

Board: 2 copper layers, 51.0 x 61.0 mm, 70 parts (0 on the bottom side), 94 nets.

Other parts of the board:
Ue: TC74LCXR163245FT; TSSOP-48_6.1x12.5mm_P0.5mm

Their connections:
+3V3: Ue.7 (VCCB), Ue.18 (VCCB), Ue.24 (2DIR); also elsewhere on the board
+5V: Ue.31 (VCCA), Ue.42 (VCCA); also elsewhere on the board
/CB-A11: Ue.26 (2A8); also elsewhere on the board
/CB-A12: Ue.27 (2A7); also elsewhere on the board
/CB-A13: Ue.29 (2A6); also elsewhere on the board
/CB-A14: Ue.30 (2A5); also elsewhere on the board
/CB-A15: Ue.32 (2A4); also elsewhere on the board
/CB-D0: Ue.37 (1A8); also elsewhere on the board
/CB-D1: Ue.38 (1A7); also elsewhere on the board
/CB-D2: Ue.40 (1A6); also elsewhere on the board
/CB-D3: Ue.41 (1A5); also elsewhere on the board
/CB-D4: Ue.43 (1A4); also elsewhere on the board
/CB-D5: Ue.44 (1A3); also elsewhere on the board
/CB-D6: Ue.46 (1A2); also elsewhere on the board
/CB-D7: Ue.47 (1A1); also elsewhere on the board
/DIR: Ue.1 (1DIR); also elsewhere on the board
/DV-A11: Ue.23 (2B8); also elsewhere on the board
/DV-A12: Ue.22 (2B7); also elsewhere on the board
/DV-A13: Ue.20 (2B6); also elsewhere on the board
/DV-A14: Ue.19 (2B5); also elsewhere on the board
/DV-A15: Ue.17 (2B4); also elsewhere on the board
/DV-D0: Ue.12 (1B8); also elsewhere on the board
/DV-D1: Ue.11 (1B7); also elsewhere on the board
/DV-D2: Ue.9 (1B6); also elsewhere on the board
/DV-D3: Ue.8 (1B5); also elsewhere on the board
/DV-D4: Ue.6 (1B4); also elsewhere on the board
/DV-D5: Ue.5 (1B3); also elsewhere on the board
/DV-D6: Ue.3 (1B2); also elsewhere on the board
/DV-D7: Ue.2 (1B1); also elsewhere on the board
GND: Ue.4 (GND), Ue.10 (GND), Ue.15 (GND), Ue.21 (GND), Ue.25 (2~OE), Ue.28 (GND), Ue.33 (2A3), Ue.34 (GND), Ue.35 (2A2), Ue.36 (2A1), Ue.39 (GND), Ue.45 (GND), Ue.48 (1~OE); also elsewhere on the board
