rniwase/tsuraraGB/examples/midi_sound_gen/gateware/rtl/cartridge_top.sv

/* cartridge_top.sv - Top module for tsuraraGB */

module cartridge_top (
  /* Clock input */
  input  logic        clk_20M,

  /* Cartridge bus interface */
  input  logic [15:0] bus_A,
  inout  logic [ 7:0] bus_D,
  output logic        bus_D_dir,
  input  logic        bus_nRD,
  input  logic        bus_nWR,
  output logic        cpu_reset,

  /* SPI flash memory */
  output logic        SPI_ss,
  output logic        SPI_so,
  input  logic        SPI_si,
  output logic        SPI_sck,

  /* LED */
  output logic [ 2:0] LED,

  /* User I/O for MIDI */
  output logic        IO0,  // Assign to MIDI thru output
  input  logic        IO1,  // Assign to MIDI input

  /* unused */
  output logic        vin
);

  logic        reset_n;
  logic        load_done;

  logic        spi_enable;
  logic        spi_idle;
  logic [ 7:0] spi_tx_len;
  logic        spi_tx_fetch;
  logic [ 7:0] spi_tx_data;
  logic [23:0] spi_rx_len;
  logic        spi_rx_store;
  logic [ 7:0] spi_rx_data;

  logic [16:0] loader_addr;
  logic [ 7:0] loader_wd;
  logic        loader_we;

  logic [16:0] cart_addr;
  logic [ 7:0] cart_rd;

  logic [15:0] bus_A_s;
  logic [ 7:0] bus_D_in;
  logic [ 7:0] bus_D_in_s;
  logic [ 7:0] bus_D_out;
  logic [ 7:0] bus_D_oe;
  logic [20:0] bus_nWR_buf;
  logic        wr_posedge;
  logic [ 2:0] rom_bank;

  logic [ 7:0] bus_D_out_midi;
  logic [ 3:0] note_act;

  logic [ 7:0] mult8x8_in_a;
  logic [ 7:0] mult8x8_in_b;
  logic [15:0] mult8x8_out;

  logic [15:0] mult16x16_in_a;
  logic [15:0] mult16x16_in_b;
  logic [31:0] mult16x16_out;

  logic [15:0] nrfreq_in;
  logic [15:0] nrfreq_out;

  assign cart_addr = {(bus_A_s[15:14] == 2'b00) ? 3'd0 : rom_bank, bus_A_s[13:0]};
  assign bus_D_dir = bus_nRD | (bus_A[15] ? ~bus_A[13] : 1'b0);  // L: read (cartridge -> GB), H: write (GB -> cartridge)
  assign bus_D_oe = {8{~bus_D_dir}};

  assign IO0 = IO1;
  assign vin = 1'bx;

  always_ff @(posedge clk_20M) begin
    if (~reset_n)
      rom_bank <= 3'd1;
    else if (wr_posedge & (bus_A_s[15:13] == 3'b001))  // bus : 2000 - 3FFF
      rom_bank <= (bus_D_in_s[2:0] == 3'd0) ? 3'd1 : bus_D_in_s[2:0];
    else
      rom_bank <= rom_bank;
  end

  always_ff @(posedge clk_20M) begin
    cpu_reset <= ~load_done;
    bus_nWR_buf <= {bus_nWR_buf[19:0], bus_nWR};
    wr_posedge <= ~bus_nWR_buf[3] & bus_nWR_buf[2];
  end

  always_ff @(posedge clk_20M) begin
    casex (bus_A_s)
      16'b1011_0xxx_xxxx_xxxx:  // B000 - B7FF
        bus_D_out <= bus_D_out_midi;
      16'b1011_10xx_xxxx_x000:  // B800
        bus_D_out <= mult16x16_in_a[ 7:0];
      16'b1011_10xx_xxxx_x001:  // B801
        bus_D_out <= mult16x16_in_a[15:8];
      16'b1011_10xx_xxxx_x010:  // B802
        bus_D_out <= mult16x16_in_b[ 7:0];
      16'b1011_10xx_xxxx_x011:  // B803
        bus_D_out <= mult16x16_in_b[15:8];
      16'b1011_10xx_xxxx_x100:  // B804
        bus_D_out <= mult16x16_out[ 7: 0];
      16'b1011_10xx_xxxx_x101:  // B805
        bus_D_out <= mult16x16_out[15: 8];
      16'b1011_10xx_xxxx_x110:  // B806
        bus_D_out <= mult16x16_out[23:16];
      16'b1011_10xx_xxxx_x111:  // B807
        bus_D_out <= mult16x16_out[31:24];
      16'b1011_11xx_xxxx_xx00:  // BC00
        bus_D_out <= nrfreq_in[ 7:0];
      16'b1011_11xx_xxxx_xx01:  // BC01
        bus_D_out <= nrfreq_in[15:8];
      16'b1011_11xx_xxxx_xx10:  // BC02
        bus_D_out <= nrfreq_out[ 7:0];
      16'b1011_11xx_xxxx_xx11:  // BC03
        bus_D_out <= nrfreq_out[15:8];
      default:
        bus_D_out <= cart_rd;
    endcase
  end

  always_ff @(posedge clk_20M) begin
    mult16x16_in_a[ 7:0] <= wr_posedge & (bus_A_s[15:10] == {4'hB, 2'b10}) & (bus_A_s[2:0] == 3'h0) ? bus_D_in_s : mult16x16_in_a[ 7:0];
    mult16x16_in_a[15:8] <= wr_posedge & (bus_A_s[15:10] == {4'hB, 2'b10}) & (bus_A_s[2:0] == 3'h1) ? bus_D_in_s : mult16x16_in_a[15:8];
    mult16x16_in_b[ 7:0] <= wr_posedge & (bus_A_s[15:10] == {4'hB, 2'b10}) & (bus_A_s[2:0] == 3'h2) ? bus_D_in_s : mult16x16_in_b[ 7:0];
    mult16x16_in_b[15:8] <= wr_posedge & (bus_A_s[15:10] == {4'hB, 2'b10}) & (bus_A_s[2:0] == 3'h3) ? bus_D_in_s : mult16x16_in_b[15:8];

    nrfreq_in[ 7:0] <= wr_posedge & (bus_A_s[15:10] == {4'hB, 2'b11}) & (bus_A_s[1:0] == 2'h0) ? bus_D_in_s : nrfreq_in[ 7:0];
    nrfreq_in[15:8] <= wr_posedge & (bus_A_s[15:10] == {4'hB, 2'b11}) & (bus_A_s[1:0] == 2'h1) ? bus_D_in_s : nrfreq_in[15:8];
  end

  reset_gen reset_gen_inst (
    .clk         (clk_20M),
    .reset_n_out (reset_n)
  );

  spi_master #(
    .DIV_RATE   (8'd0        ),
    .INPUT_SYNC (4'd5        )
  ) spi_master_inst (
    .clk        (clk_20M     ),
    .reset_n    (reset_n     ),
    .enable     (spi_enable  ),
    .idle       (spi_idle    ),
    .tx_len     (spi_tx_len  ),
    .tx_fetch   (spi_tx_fetch),
    .tx_data    (spi_tx_data ),
    .rx_len     (spi_rx_len  ),
    .rx_store   (spi_rx_store),
    .rx_data    (spi_rx_data ),
    .spi_ss     (SPI_ss      ),
    .spi_so     (SPI_so      ),
    .spi_si     (SPI_si      ),
    .spi_sck    (SPI_sck     )
  );

  flash2spram #(
    .LOAD_OFFSET  (24'h080000  ),  // in bytes
    .LOAD_SIZE    (24'h020000  ),  // in bytes
    .RESET_TIME   (10'd700     )
  ) flash2spram_inst (
    .clk          (clk_20M     ),
    .reset_n      (reset_n     ),
    .load_done    (load_done   ),
    .spram_addr   (loader_addr ),
    .spram_we     (loader_we   ),
    .spram_wd     (loader_wd   ),
    .spi_enable   (spi_enable  ),
    .spi_idle     (spi_idle    ),
    .spi_tx_len   (spi_tx_len  ),
    .spi_tx_fetch (spi_tx_fetch),
    .spi_tx_data  (spi_tx_data ),
    .spi_rx_len   (spi_rx_len  ),
    .spi_rx_store (spi_rx_store),
    .spi_rx_data  (spi_rx_data )
  );

  SP256K_4x SP256K_4x_inst (
    .clk        (clk_20M                            ),
    .addr       (load_done ? cart_addr : loader_addr),
    .din        (loader_wd                          ),
    .dout       (cart_rd                            ),
    .wren       (loader_we                          ),
    .cs         (1'b1                               ),
    .standby    (1'b0                               ),
    .sleep      (1'b0                               ),
    .poweroff_n (1'b1                               )
  );

  bidir_pad bus_D_pad (
    .clk       (clk_20M   ),
    .d_in      (bus_D_out ),
    .d_out     (bus_D_in  ),
    .oe        (bus_D_oe  ),
    .pad       (bus_D     )
  );

  pipe_buf #(
    .WIDTH     (16),
    .NUM_STAGE ( 4)
  ) sync_bus_A (
    .clk       (clk_20M   ),
    .din       (bus_A     ),
    .dout      (bus_A_s   )
  );

  pipe_buf #(
    .WIDTH     (8),
    .NUM_STAGE (4)
  ) sync_bus_D_in (
    .clk       (clk_20M   ),
    .din       (bus_D_in  ),
    .dout      (bus_D_in_s)
  );

  midi_rx midi_rx_inst (
    .clk          (clk_20M       ),
    .reset_n      (reset_n       ),
    .midi_in      (IO1           ),
    .bus_A        (bus_A_s[7:0]  ),
    .bus_D_out    (bus_D_out_midi),
    .note_act     (note_act      )
  );

  mult_16x16 #(
    .REG_INPUT    (1),
    .REG_INTERNAL (1),
    .REG_OUTPUT   (1)
  ) mult_16x16_inst (
    .clk        (clk_20M       ),
    .in_a       (mult16x16_in_a),
    .in_b       (mult16x16_in_b),
    .out        (mult16x16_out )
  );

  nrfreq_interpolator nrfreq_interpolator_inst (
    .clk  (clk_20M   ),
    .din  (nrfreq_in ),
    .dout (nrfreq_out)
  );

  led_driver led_driver_inst (
    .din (note_act[2:0]),
    .pad (LED)
  );

endmodule
