rniwase/tsuraraGB/examples/common/gateware/rtl/reset_gen.sv

/* reset_gen.sv - Reset signal generator */

module reset_gen #(
  parameter ASSERT_LEN = 63
)(
  input  logic clk,
  output logic reset_n_out
);

  localparam CNT_WIDTH = $clog2(ASSERT_LEN + 1);;

  logic [CNT_WIDTH-1:0] count;
  logic count_match;
  assign count_match = (count == ASSERT_LEN);

  initial begin
    count <= CNT_WIDTH'(0);
    reset_n_out <= 1'b0;
  end

  always_ff @(posedge clk) begin
    count <= count_match ? count : count + CNT_WIDTH'(1);
    reset_n_out <= count_match;
  end

endmodule
