rniwase/tsuraraGB/examples/midi_sound_gen/gateware/rtl/ptcam.sv

/* ptcam.sv - Pseudo Ternary Content Addressable Memory */

module ptcam #(
  parameter DWIDTH = 19,
  parameter MEMSIZE = 16,
  localparam BW_MEM = $clog2(MEMSIZE)
)(
  input  logic              clk,
  input  logic              reset_n,

  input  logic [BW_MEM-1:0] w_addr,  // Write address
  input  logic [DWIDTH-1:0] w_din,   // Write data input
  input  logic [DWIDTH-1:0] w_mask,  // Write data mask
  input  logic              w_en,    // Write enable
  input  logic [BW_MEM-1:0] r_addr,  // Read address
  output logic [DWIDTH-1:0] r_dout,  // Read data output

  input  logic [DWIDTH-1:0] search_din,      // Search data input
  input  logic [DWIDTH-1:0] search_mask,     // Search data mask
  input  logic              search_en,       // Search enable
  output logic              search_valid,    // Search result valid
  output logic [DWIDTH-1:0] search_dout,     // Search result data output
  output logic [BW_MEM-1:0] search_addr_out, // Search result address
  output logic              search_notfound  // Search result not found
);

  integer i;

  logic [DWIDTH-1:0] mem [0:MEMSIZE-1];
  logic [DWIDTH-1:0] search_din_str, search_mask_str;
  logic [BW_MEM-1:0] search_addr;
  logic search_busy, search_match, end_of_search;

  assign search_match = (mem[search_addr] & search_mask_str) == (search_din_str & search_mask_str);
  assign end_of_search = search_addr == MEMSIZE-1;

  always_ff @(posedge clk) begin
    if (~reset_n) begin
      for (i=0; i<MEMSIZE; i=i+1)
        mem[i] <= 'd0;
    end
    else if (w_en)
      mem[w_addr] <= (w_din & w_mask) | (mem[w_addr] & ~w_mask);
  end

  always_ff @(posedge clk)
    r_dout <= mem[r_addr];

  always_ff @(posedge clk) begin
    if (~search_busy & search_en) begin
      search_din_str <= search_din;
      search_mask_str <= search_mask;
    end
  end

  always_ff @(posedge clk) begin
    if (~reset_n)
      search_busy <= 1'b0;
    else if (search_busy & (search_match | end_of_search))
      search_busy <= 1'b0;
    else if (~search_busy & search_en)
      search_busy <= 1'b1;
  end

  always_ff @(posedge clk) begin
    if (~reset_n)
      search_addr <= 'd0;
    else if (search_busy) begin
      if (search_match | end_of_search)
        search_addr <= 'd0;
      else
        search_addr <= search_addr + BW_MEM'(1);
    end
  end

  always_ff @(posedge clk) begin
    if (~reset_n)
      search_dout <= 'd0;
    else if (search_match)
      search_dout <= mem[search_addr];
  end

  always_ff @(posedge clk) begin
    if (~reset_n)
      search_addr_out <= 'd0;
    else if (search_match)
      search_addr_out <= search_addr;
  end

  always_ff @(posedge clk) begin
    if (~reset_n)
      search_notfound <= 1'b0;
    else if (search_match)
      search_notfound <= 1'b0;
    else if (end_of_search)
      search_notfound <= 1'b1;
  end

  always_ff @(posedge clk)
    search_valid <= search_busy & (end_of_search | search_match);

endmodule
