rniwase/tsuraraGB/(commit log)

2020-12-08 modify value fields
    [iCEboy-pcb.kicad_pcb, iCEboy-pcb.sch]
2020-12-08 modify decoup C value
    [iCEboy-pcb.kicad_pcb, iCEboy-pcb.sch]
2020-12-10 change value of X1
    [iCEboy-pcb.kicad_pcb, iCEboy-pcb.sch]
2020-12-13 add sample (wip)
2020-12-15 update sample
2020-12-16 update LED current limiting resistors
    [iCEboy-pcb.kicad_pcb, iCEboy-pcb.sch]
2020-12-16 swap C11 C14 value
    [iCEboy-pcb.kicad_pcb, iCEboy-pcb.sch]
2022-05-05 migrate to KiCAD 6.0
    [iCEboy-pcb.kicad_pcb, iCEboy-pcb.kicad_sch, iCEboy-pcb.sch]
2022-05-07 replace X1 parts on schematic
2022-05-07 update schematic, change Lx to FBx, add LPF circuit for Vin, reselection of some components
    [iCEboy-pcb.kicad_sch]
2022-05-08 update pcb wip
    [iCEboy-pcb.kicad_pcb]
2022-05-08 update pcb, drc ok
    [iCEboy-pcb.kicad_pcb]
2022-05-09 update board setup
    [iCEboy-pcb.kicad_pcb]
2022-05-14 change pin headers to THT, tweaking placement
    [iCEboy-pcb.kicad_pcb, iCEboy-pcb.kicad_sch]
2022-05-14 add mounting hole
    [iCEboy-pcb.kicad_pcb, iCEboy-pcb.kicad_sch]
2022-05-15 update illustration
    [iCEboy-pcb.kicad_pcb]
2022-05-17 add reverse current protection circuit between VCC and 5V, remove mounthole
    [iCEboy-pcb.kicad_pcb, iCEboy-pcb.kicad_sch]
2022-05-19 update cardedge
    [iCEboy-pcb.kicad_pcb]
2022-05-19 rename project
    [iCEboy-pcb-B_Cu.gbr, iCEboy-pcb-B_Mask.gbr, iCEboy-pcb-B_SilkS.gbr, iCEboy-pcb-Edge_Cuts.gbr, iCEboy-pcb-F_Cu.gbr, iCEboy-pcb-F_Mask.gbr, iCEboy-pcb-F_SilkS.gbr, iCEboy-pcb-NPTH.drl]
2022-05-19 rename project, update pcb
    [tGB-main.kicad_pcb, tGB-main.kicad_sch]
2022-06-12 update R16,R17 value
    [tGB-main.kicad_pcb, tGB-main.kicad_sch]
2022-07-18 add midi extension pcb
    [tGB-main.kicad_pcb, tGB-main.kicad_sch, tGB-midi.kicad_pcb, tGB-midi.kicad_sch]
2022-07-18 common symbols and footprints
    [tGB-main.kicad_pcb, tGB-main.kicad_sch]
2022-08-27 add programmer pcb (wip)
    [tGB-prog.kicad_pcb, tGB-prog.kicad_sch]
2022-08-29 update pcb (wip)
    [tGB-midi.kicad_pcb, tGB-prog.kicad_pcb, tGB-prog.kicad_sch]
2022-09-16 replace FT232H with FT2232D to use UART in secondary
    [tGB-prog.kicad_sch]
2022-09-16 complete placement and route of components, DRC passed with warnings
    [tGB-prog.kicad_pcb, tGB-prog.kicad_sch]
2022-09-16 fix silkscreens
    [tGB-midi.kicad_pcb, tGB-prog.kicad_pcb]
2022-09-17 add silkscreen of board name
    [tGB-midi.kicad_pcb, tGB-prog.kicad_pcb]
2022-09-24 axis origin and plot setup
    [tGB-midi.kicad_pcb, tGB-prog.kicad_pcb]
2022-09-24 fix D+ and D- polarity reversal on USB
    [tGB-prog.kicad_pcb, tGB-prog.kicad_sch]
2022-09-24 change C4 value from 10uF to 4.7uF
    [tGB-midi.kicad_pcb, tGB-midi.kicad_sch]
2022-09-25 change Y1 parts, centering of USB connector
    [tGB-prog.kicad_pcb, tGB-prog.kicad_sch]
2022-09-25 add junpers for VDDIO supply from main board, add power LED
    [tGB-prog.kicad_pcb, tGB-prog.kicad_sch]
2022-09-25 separate USB GND and shield
    [tGB-prog.kicad_pcb, tGB-prog.kicad_sch]
2022-09-25 optimize GND and shield zone, fillet USB data tracks
    [tGB-prog.kicad_pcb]
2022-10-01 add comments
    [tGB-prog.kicad_sch]
2022-10-01 add comment, fix power net name
    [tGB-midi.kicad_pcb, tGB-midi.kicad_sch]
2022-10-01 set title and revision
    [tGB-main.kicad_pcb, tGB-main.kicad_sch, tGB-midi.kicad_pcb, tGB-midi.kicad_sch, tGB-prog.kicad_pcb, tGB-prog.kicad_sch]
2023-12-29 add Backpanel draft
    [tGB-Assembly.dxf, tGB-Backpanel.dxf, tGB-Spacer.dxf]
2024-01-04 migration from KiCad 6 to 7
    [tGB-main.kicad_pcb, tGB-main.kicad_sch, tGB-midi.kicad_pcb, tGB-midi.kicad_sch, tGB-prog.kicad_pcb, tGB-prog.kicad_sch]
2024-01-04 remove workflow check-pcb
2026-04-14 examples: migrate gateware build environment to OSS CAD Suite, update Makefile, programmer scripts
2026-04-14 midi_sound_gen: update for OSS CAD Suite 20260412 and GBDK 4.5.0
2026-05-09 offload frequency table to gateware, add pitch bend and volume control, fix MIDI parser for handling system messages
    [cartridge_top.sv, midi_parser.sv, midi_rx.sv, nrfreq_interpolator.sv, nrfreq_table.sv]
